Hesham-Nabil/metal-detector-analog-design/Img/PCB.jpg

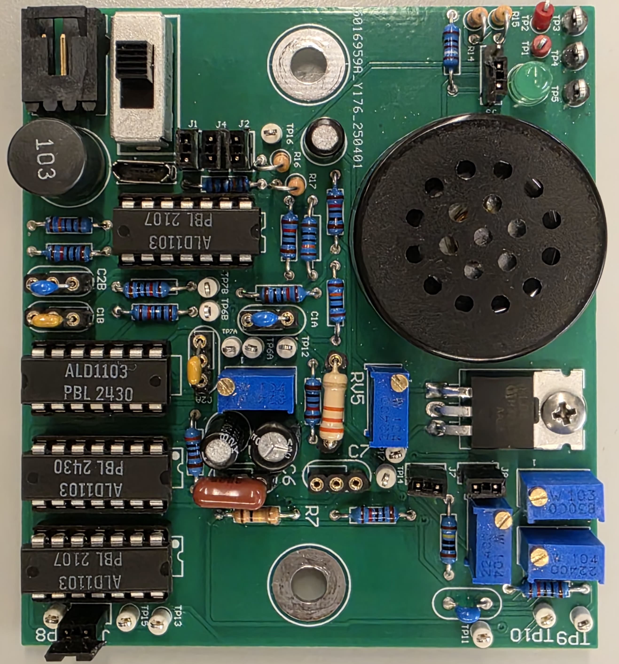
Img/PCB.jpg
