Hesham-Nabil/metal-detector-analog-design/Img/Fixed_Oscillator_Stage.png

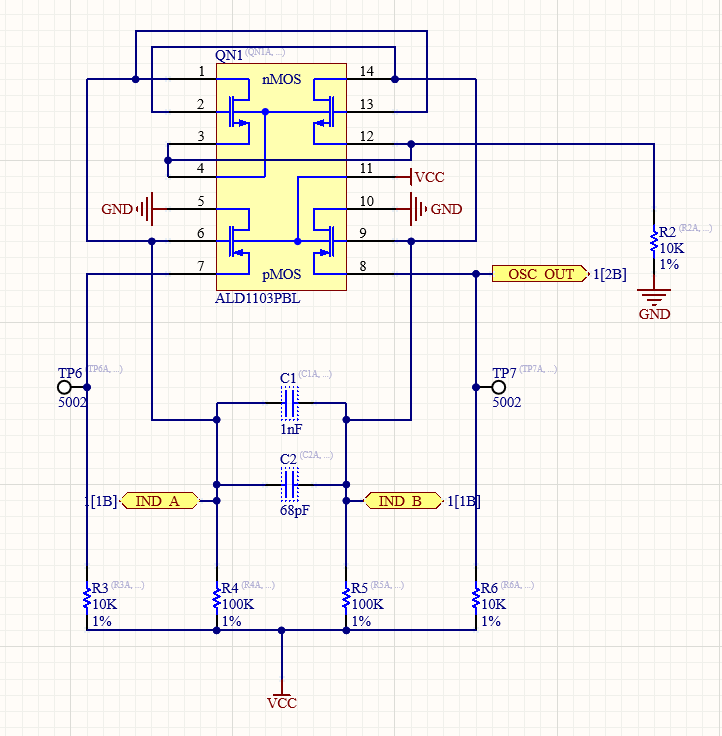
Img/Fixed_Oscillator_Stage.png
