Hesham-Nabil/metal-detector-analog-design/Img/Fixed_Oscillstor.png

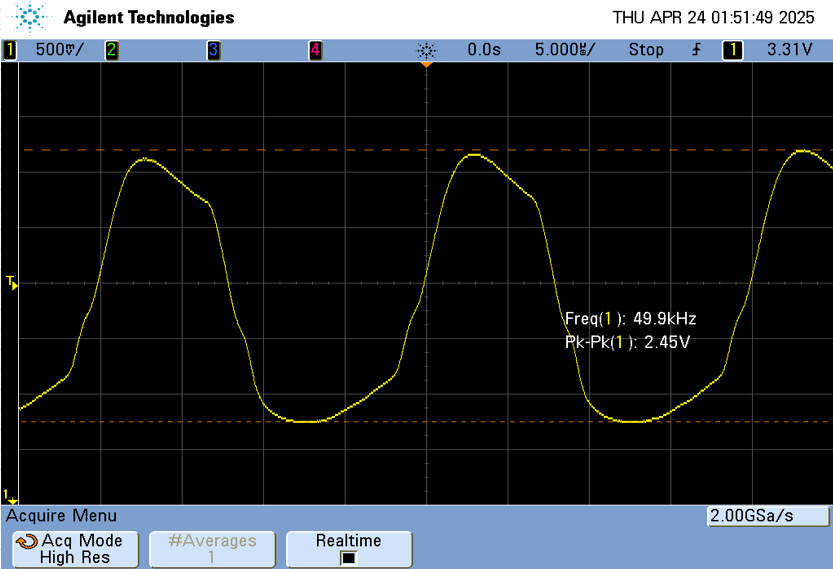
Img/Fixed_Oscillstor.png
