Hesham-Nabil/metal-detector-analog-design/Img/LPF_Output_FFT_TP15.png

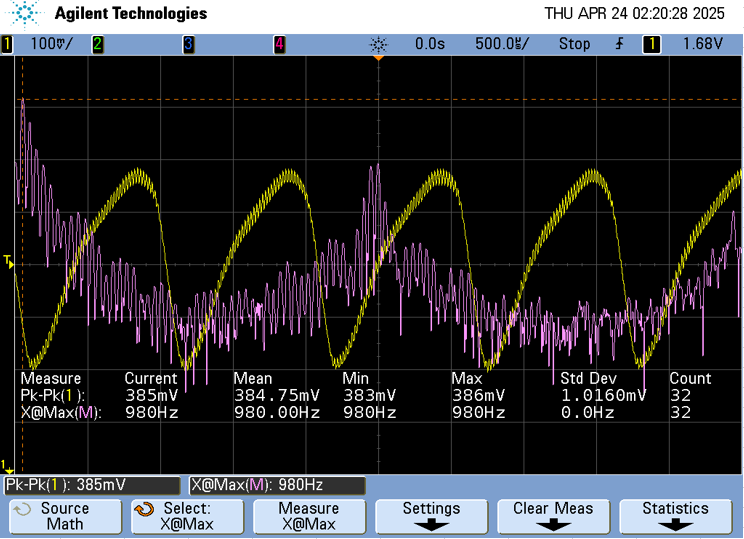
Img/LPF_Output_FFT_TP15.png
