Hesham-Nabil/metal-detector-analog-design/Img/Mixer_CS_output_TP13_Simulation.png

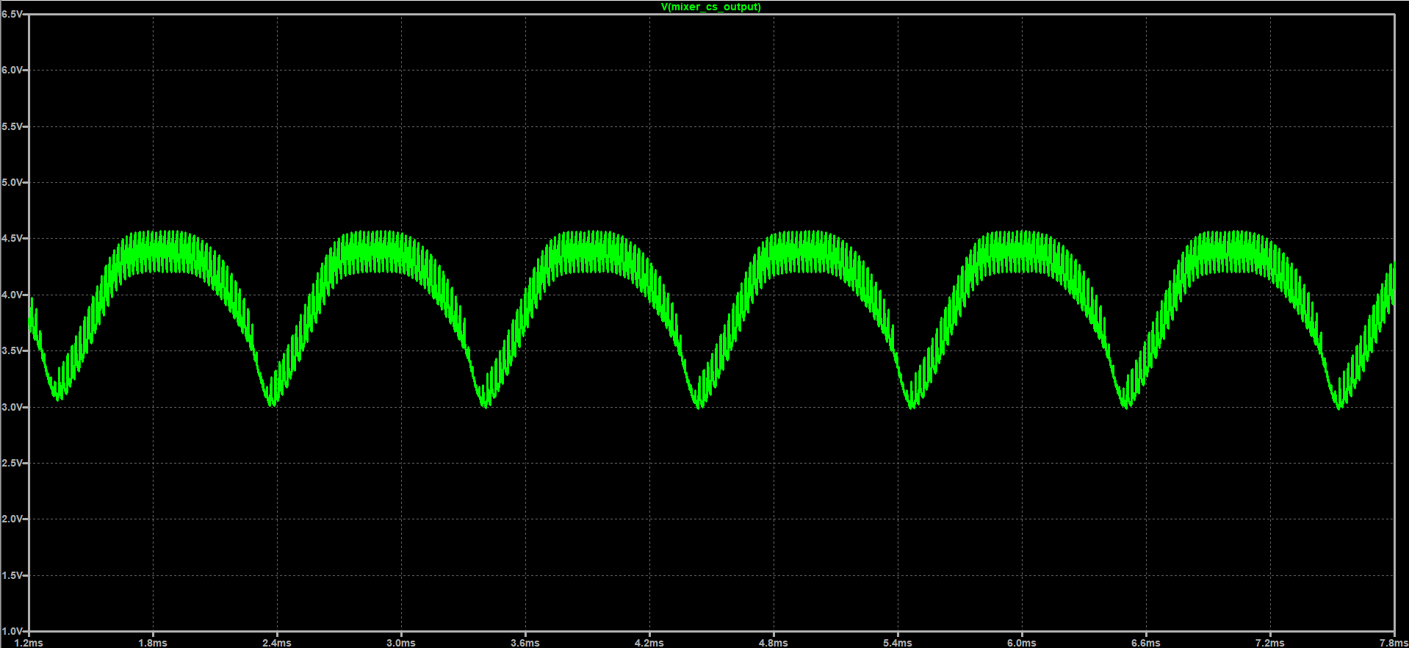
Img/Mixer_CS_output_TP13_Simulation.png
