Hesham-Nabil/metal-detector-analog-design/Img/Mixer_Diff_output_TP8.png

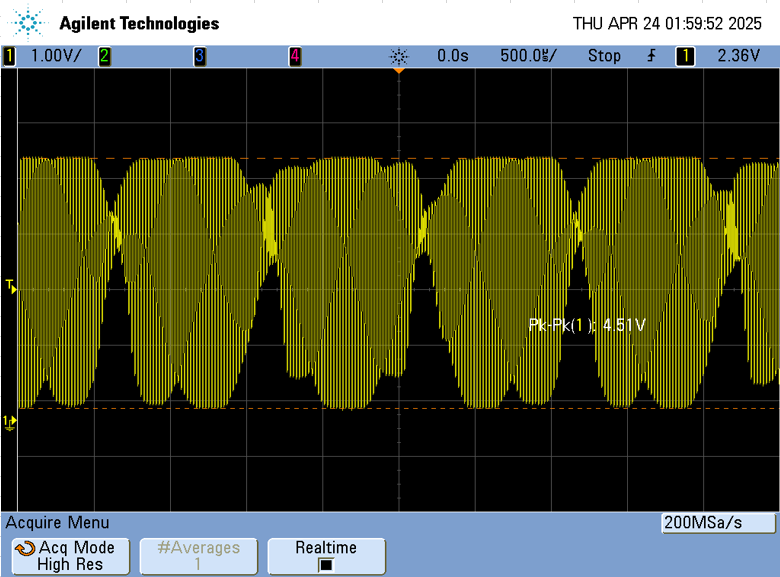
Img/Mixer_Diff_output_TP8.png
