Hesham-Nabil/metal-detector-analog-design/Img/Mixer_Diff_output_TP8_FFT.png

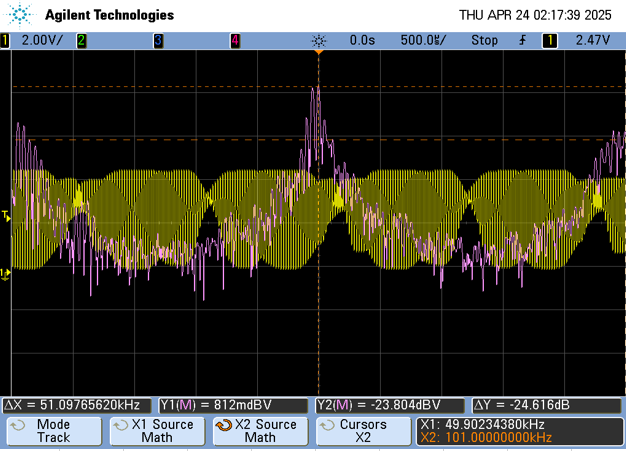
Img/Mixer_Diff_output_TP8_FFT.png
