Hesham-Nabil/metal-detector-analog-design/Img/Mixer_Output_TP16_FFT.png

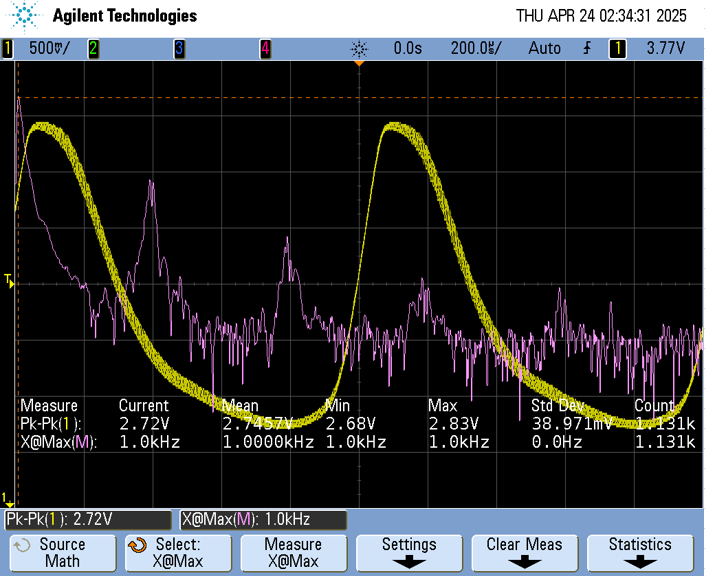
Img/Mixer_Output_TP16_FFT.png
