Hesham-Nabil/metal-detector-analog-design/Img/Mixer_Output_TP16_FFT_Simulation.png

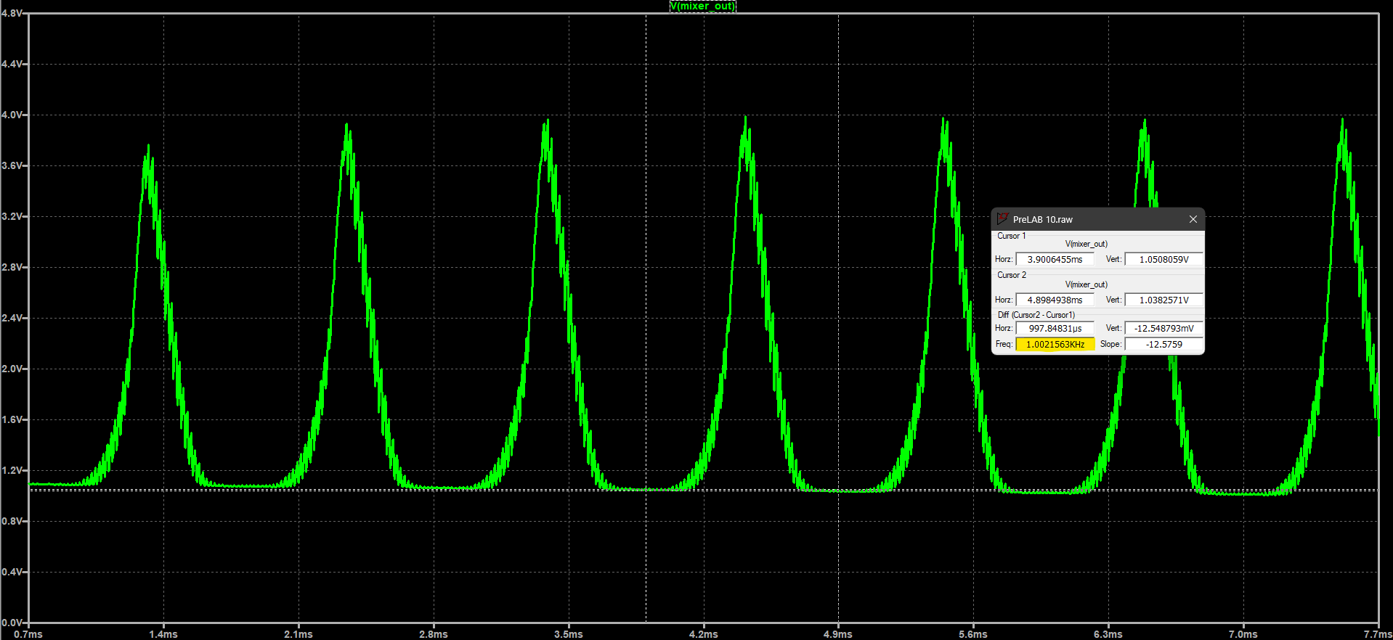
Img/Mixer_Output_TP16_FFT_Simulation.png
