Hesham-Nabil/metal-detector-analog-design/Img/PCB_bottom_Layer.png

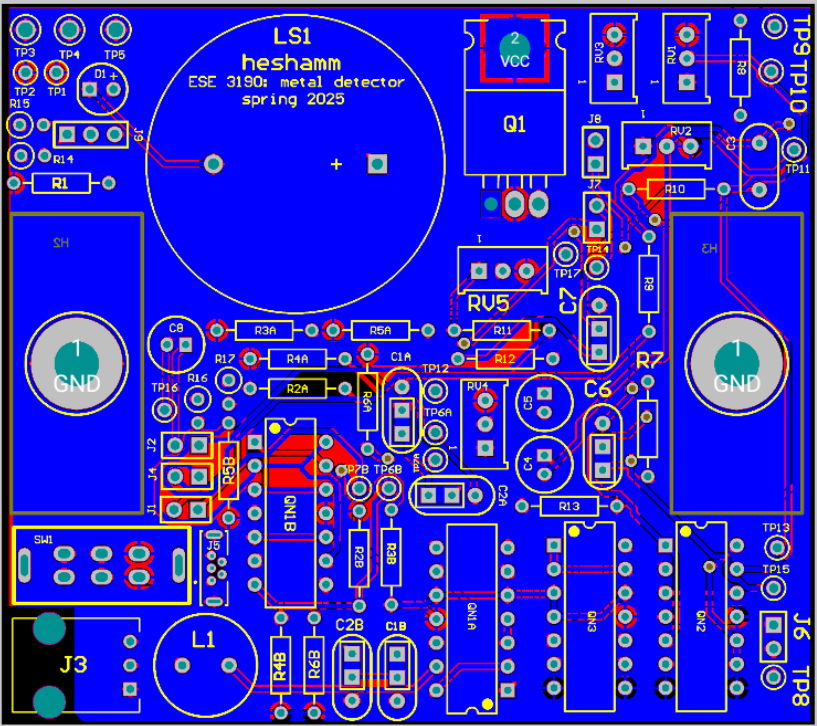
Img/PCB_bottom_Layer.png
