Hesham-Nabil/metal-detector-analog-design/Img/Speaker_Output_TP17_FFT.png

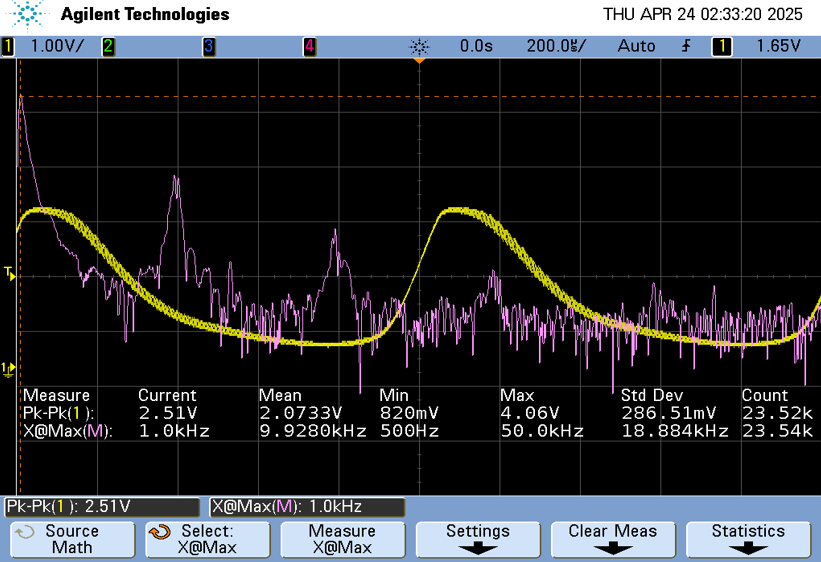
Img/Speaker_Output_TP17_FFT.png
