Hesham-Nabil/metal-detector-analog-design/Img/Variable_Oscillator_Stage.png

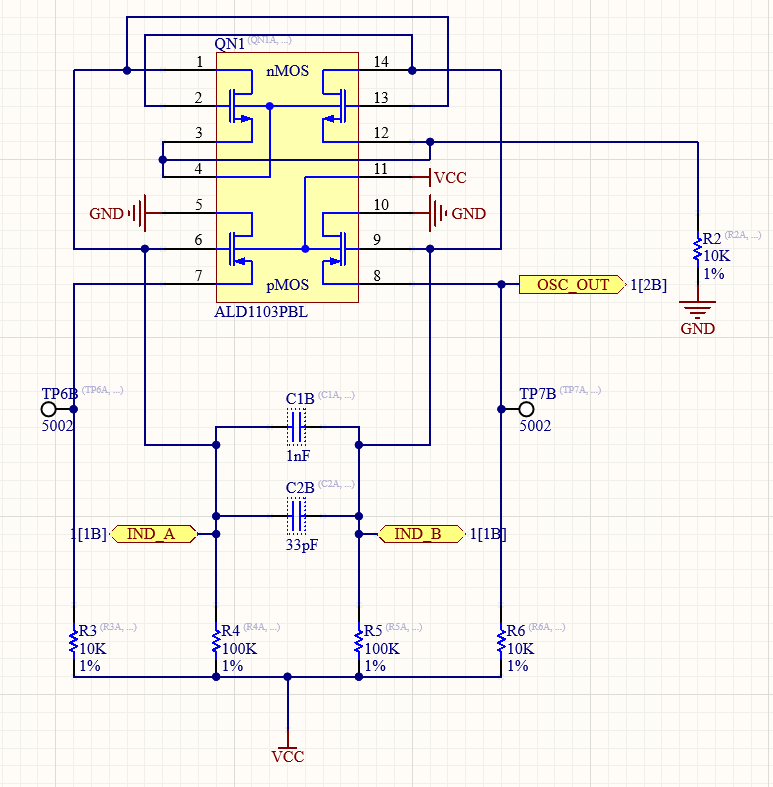
Img/Variable_Oscillator_Stage.png
