Hesham-Nabil/metal-detector-analog-design/PreLab/Circuit.png

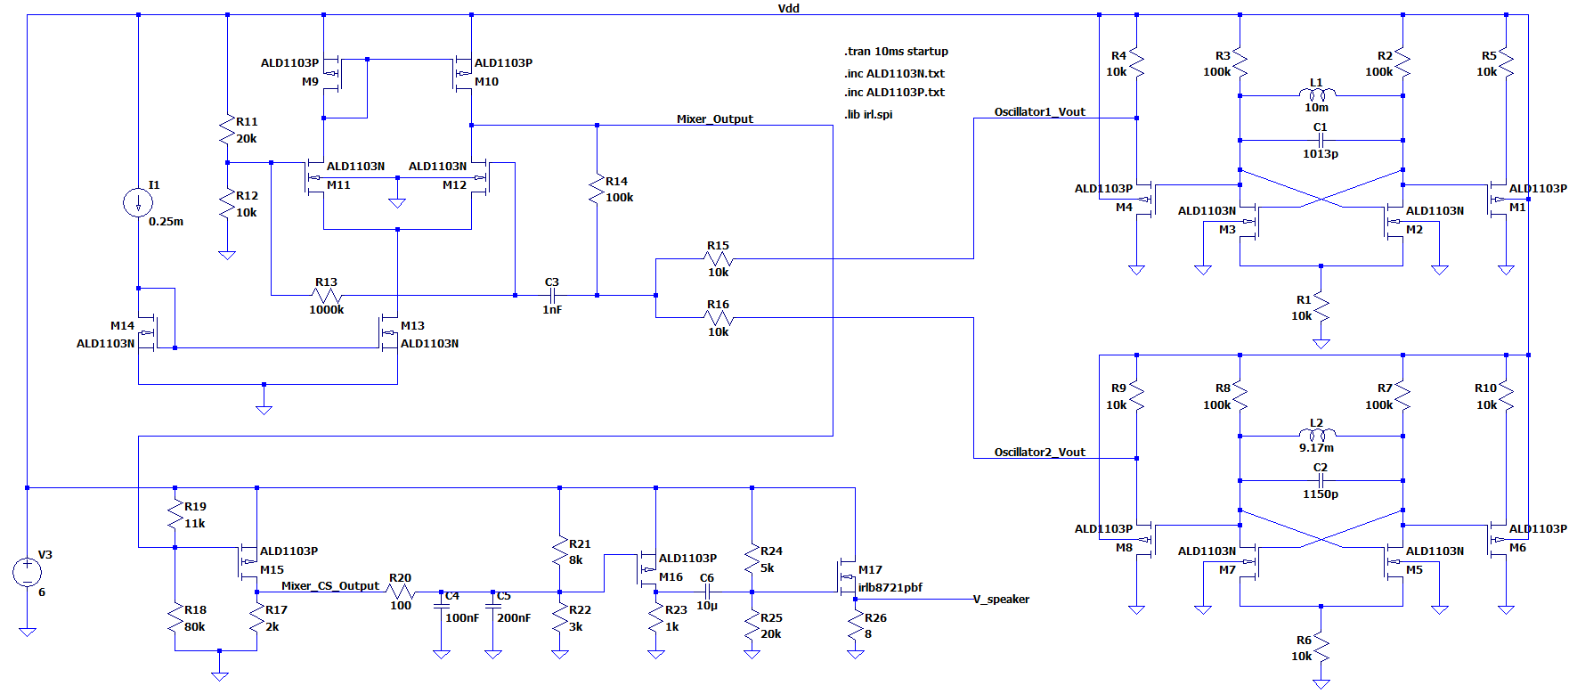
PreLab/Circuit.png
