Hesham-Nabil/metal-detector-analog-design/PreLab/Mixer_Out2.png

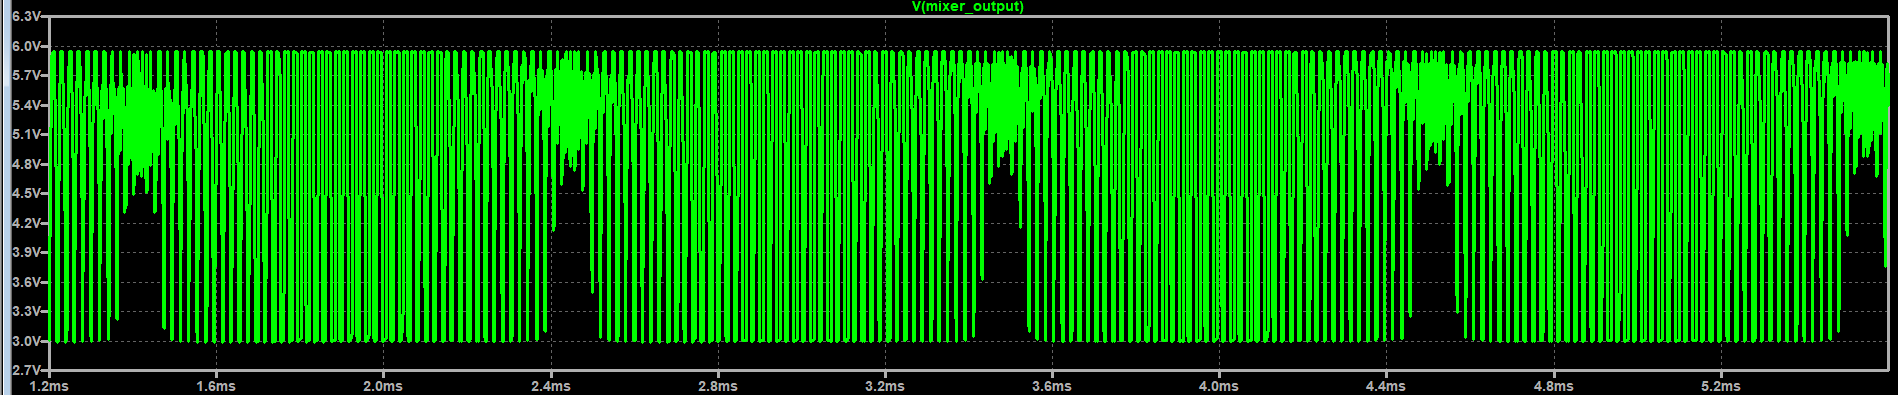
PreLab/Mixer_Out2.png
