Hesham-Nabil/metal-detector-analog-design/PreLab/Mixer_Out.png

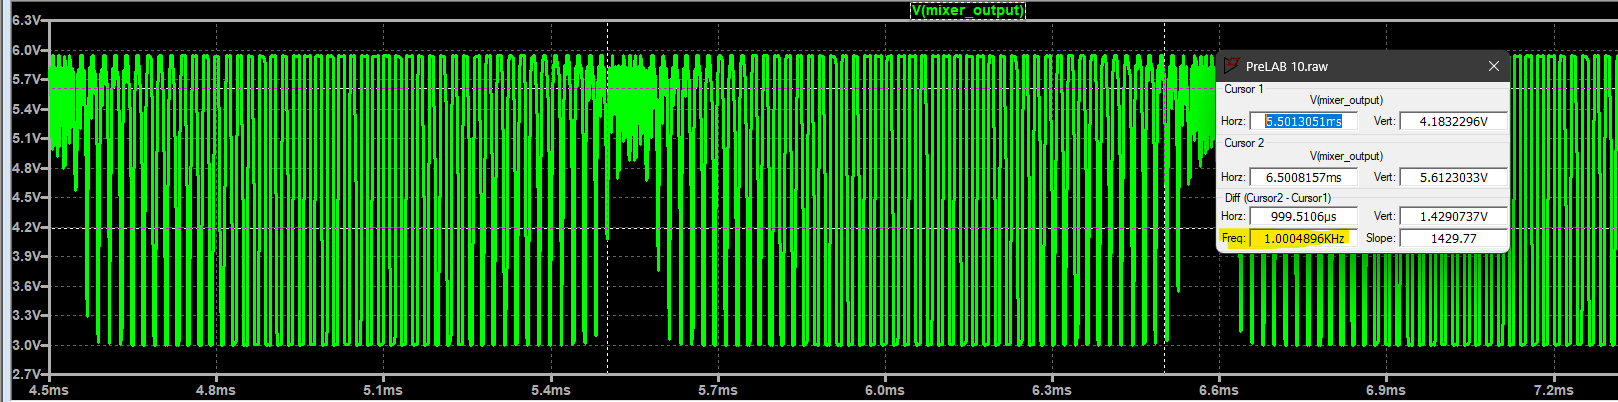
PreLab/Mixer_Out.png
