Hesham-Nabil/metal-detector-analog-design/PreLab/Mixer_Out_After2.png

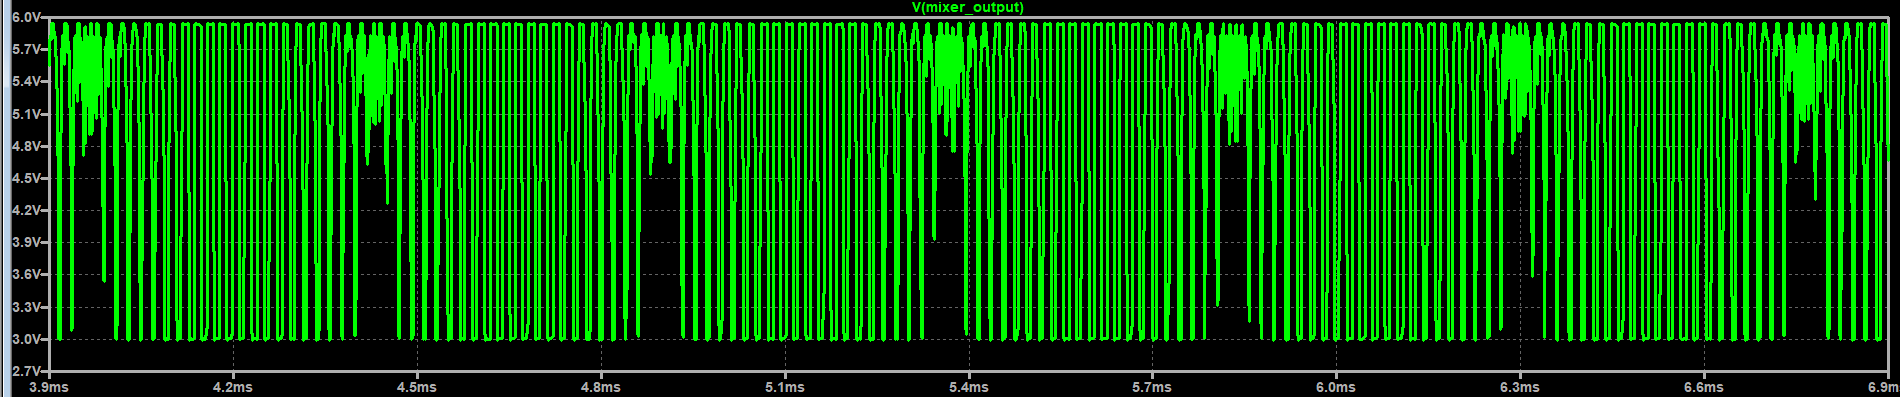
PreLab/Mixer_Out_After2.png
