Hesham-Nabil/metal-detector-analog-design/PreLab/Mixer_Out_After.png

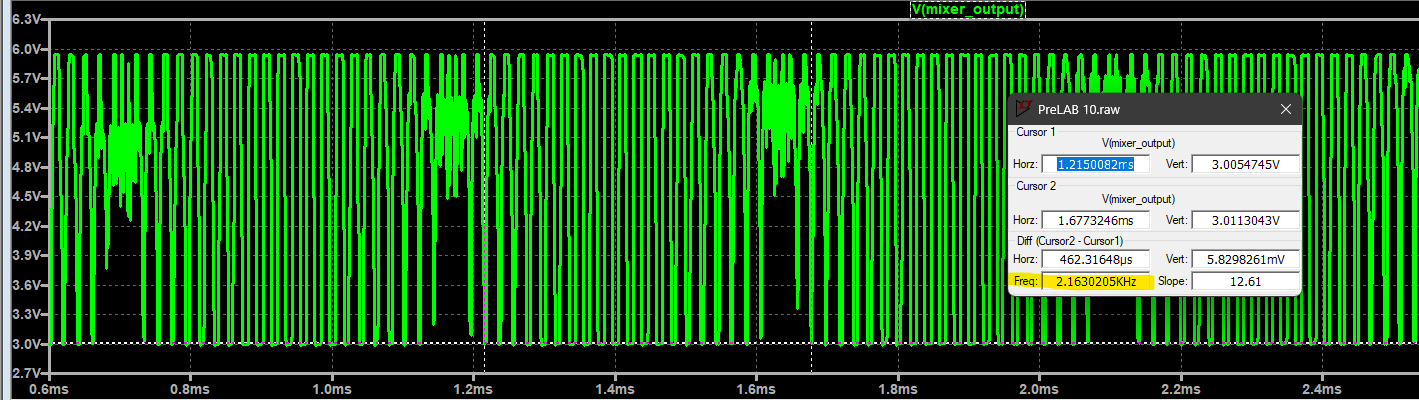
PreLab/Mixer_Out_After.png
