Hesham-Nabil/metal-detector-analog-design/PreLab/Oscillator_out1.png

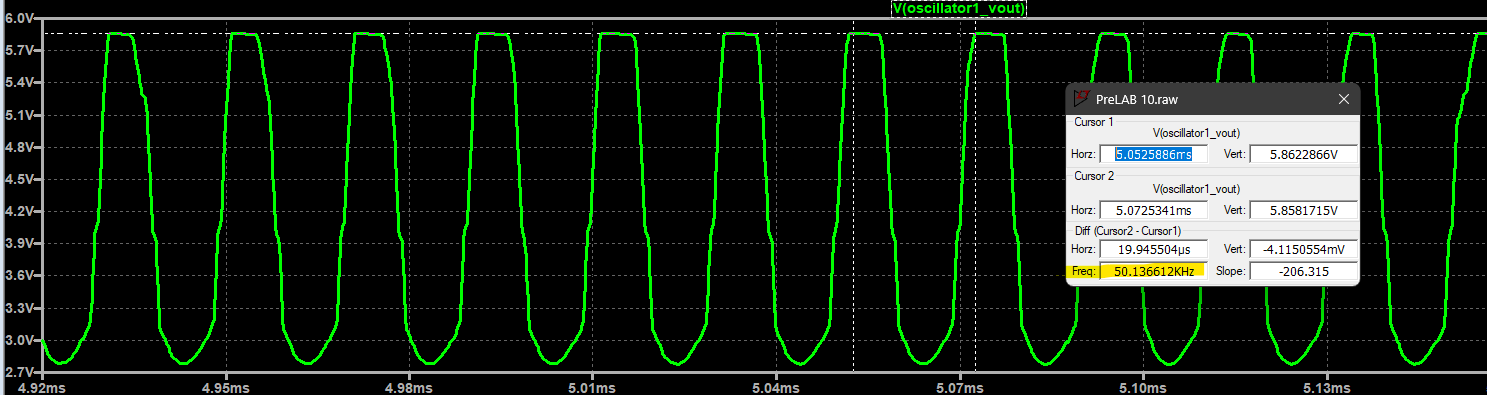
PreLab/Oscillator_out1.png
