Hesham-Nabil/metal-detector-analog-design/PreLab/Oscillator_out1_afterIncrease.png

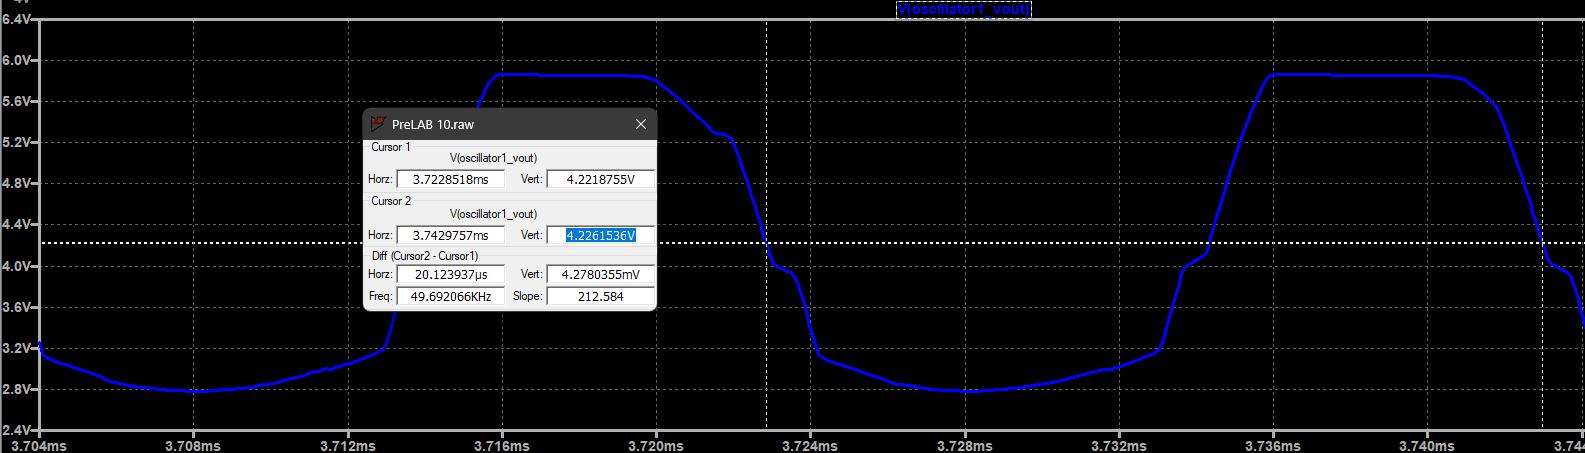
PreLab/Oscillator_out1_afterIncrease.png
