Hesham-Nabil/metal-detector-analog-design/PreLab/Oscillator_out2.png

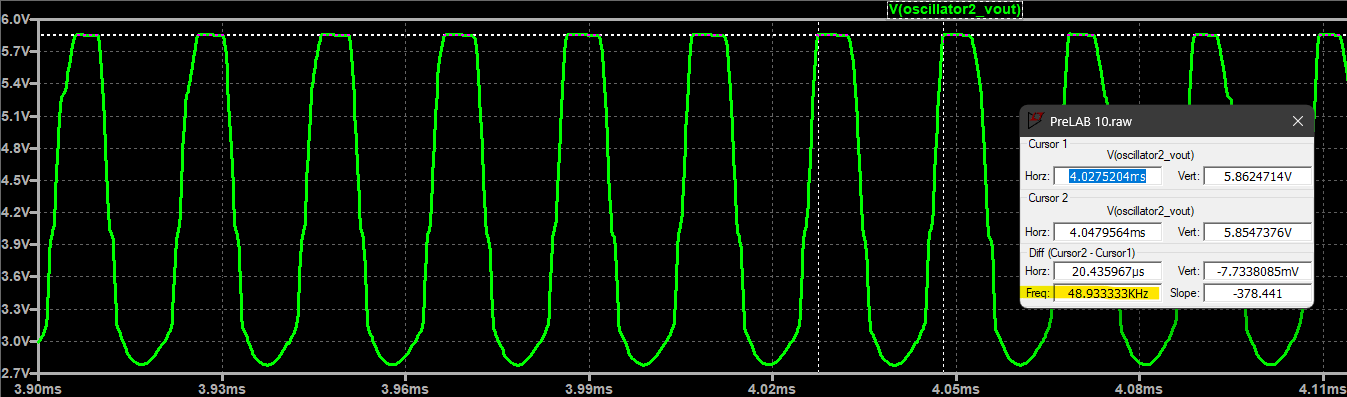
PreLab/Oscillator_out2.png
