Hesham-Nabil/metal-detector-analog-design/PreLab/Oscillator_out2_afterIncrease.png

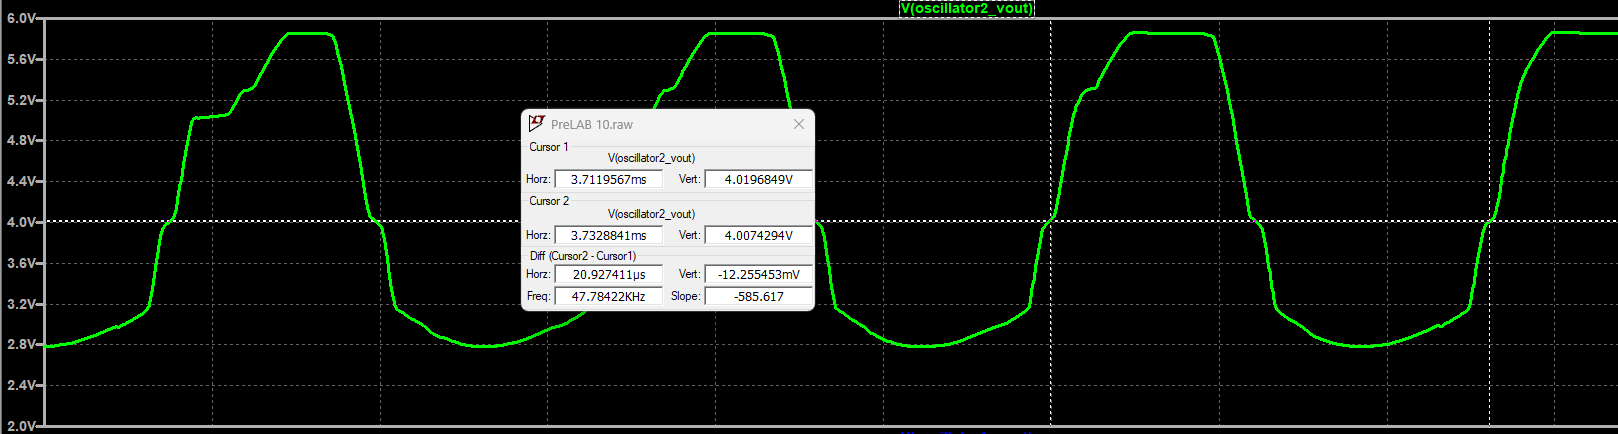
PreLab/Oscillator_out2_afterIncrease.png
