Hesham-Nabil/metal-detector-analog-design/PreLab/out_before.png

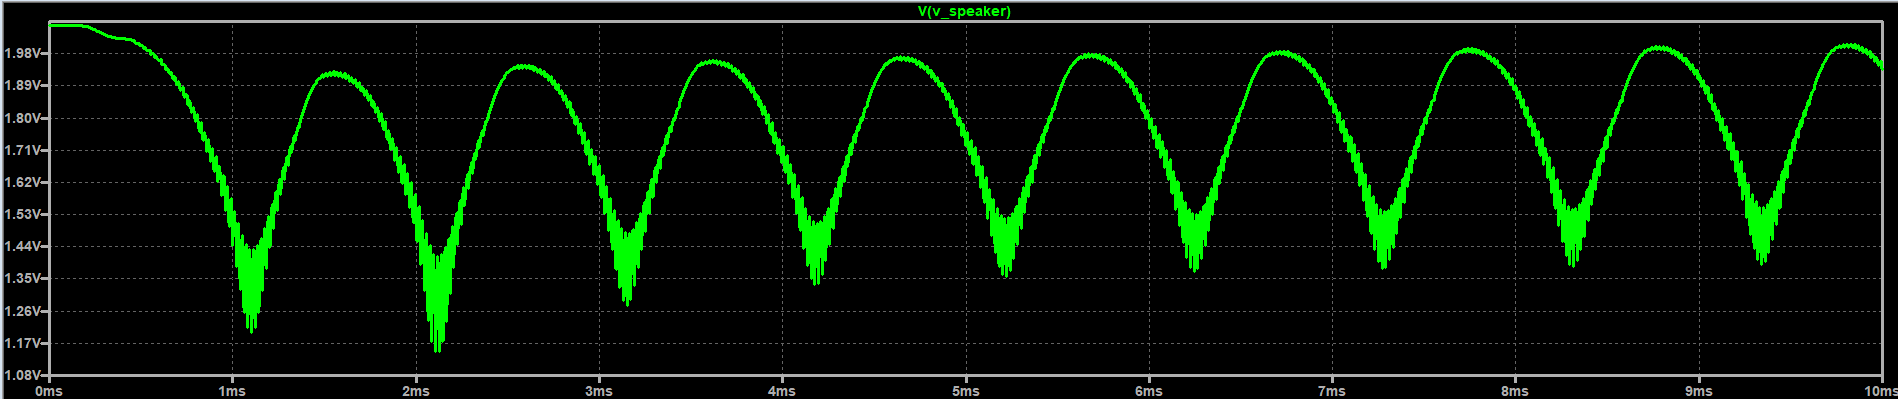
PreLab/out_before.png
