Hesham-Nabil/metal-detector-analog-design/Simulation Files/Final_Project_Schematic.asc

C1: cap; 1013p
C2: cap; 1150p
C3: cap; 1nF
C4: cap; 40n
C6: cap; 10µ
I1: current; 0.05m
L1: ind; 10m
L2: ind; 9.17m
M1: pmos4; ALD1103P
M2: nmos4; ALD1103N
M3: nmos4; ALD1103N
M4: pmos4; ALD1103P
M5: nmos4; ALD1103N
M6: pmos4; ALD1103P
M7: nmos4; ALD1103N
M8: pmos4; ALD1103P
M9: pmos; ALD1103P
M10: pmos; ALD1103P
M11: nmos4; ALD1103N
M12: nmos4; ALD1103N
M13: nmos; ALD1103N
M14: nmos; ALD1103N
M15: pmos; ALD1103P
M16: pmos; ALD1103P
M17: nmos; irlb8721pbf
R1: res; 10k
R2: res; 100k
R3: res; 100k
R4: res; 10k
R5: res; 10k
R6: res; 10k
R7: res; 100k
R8: res; 100k
R9: res; 10k
R10: res; 10k
R11: res; 30k
R12: res; 10k
R13: res; 1000k
R14: res; 100k
R15: res; 10k
R16: res; 10k
R17: res; 6k
R18: res; 80k
R19: res; 24k
R20: res; 100
R21: res; 5k
R22: res; 20k
R23: res; 2k
R24: res; 1k
R25: res; 22k
R26: res; 8
V3: voltage; 5
Named nets: 0, Fixed_Oscillator, Variable_Oscillator, Mixer_Diff_Out, Vdd, Mixer_CS_Output, V_speaker, T9, TP10, Mixer_Out, TP11, TP12
.inc ALD1103N.txt
.inc ALD1103P.txt
.lib irl.spi
.tran 10m
